jibonaronno/kicad_projects/README.md

# kicad_projects
1. Trailing Edge Dimmer ESP8266
