jibonaronno/kicad_projects/dimmer_trailing_edge/nodemcu01/README.md

# Trailing Edge Dimmer Description

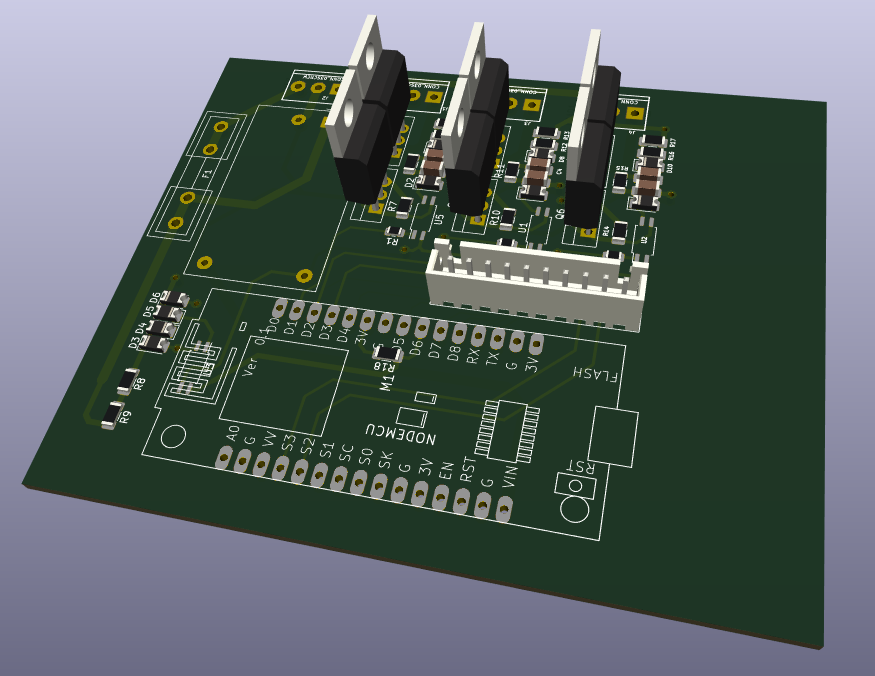
[picture p1: dimmer_trailing_edge/nodemcu01/image.png]


Practically there are 2 types of dimmer. 

1. Raising Edge
2. Trailing Edge

Based on the swithing time position after zero cross detection. 

Here is a simple concept of raising and trailing edge switching.

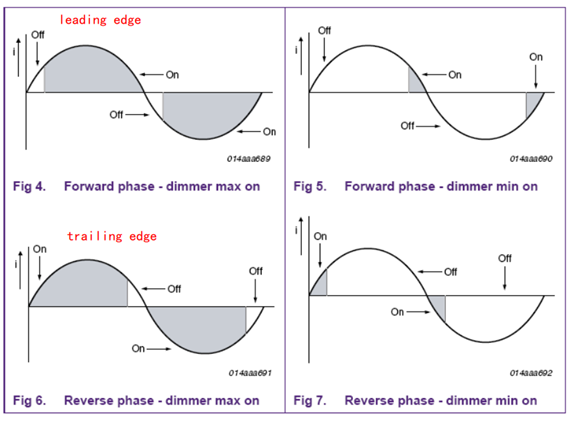
[picture p2: dimmer_trailing_edge/nodemcu01/image 1.png]


This project focused on trailing edge dimmer construction. 

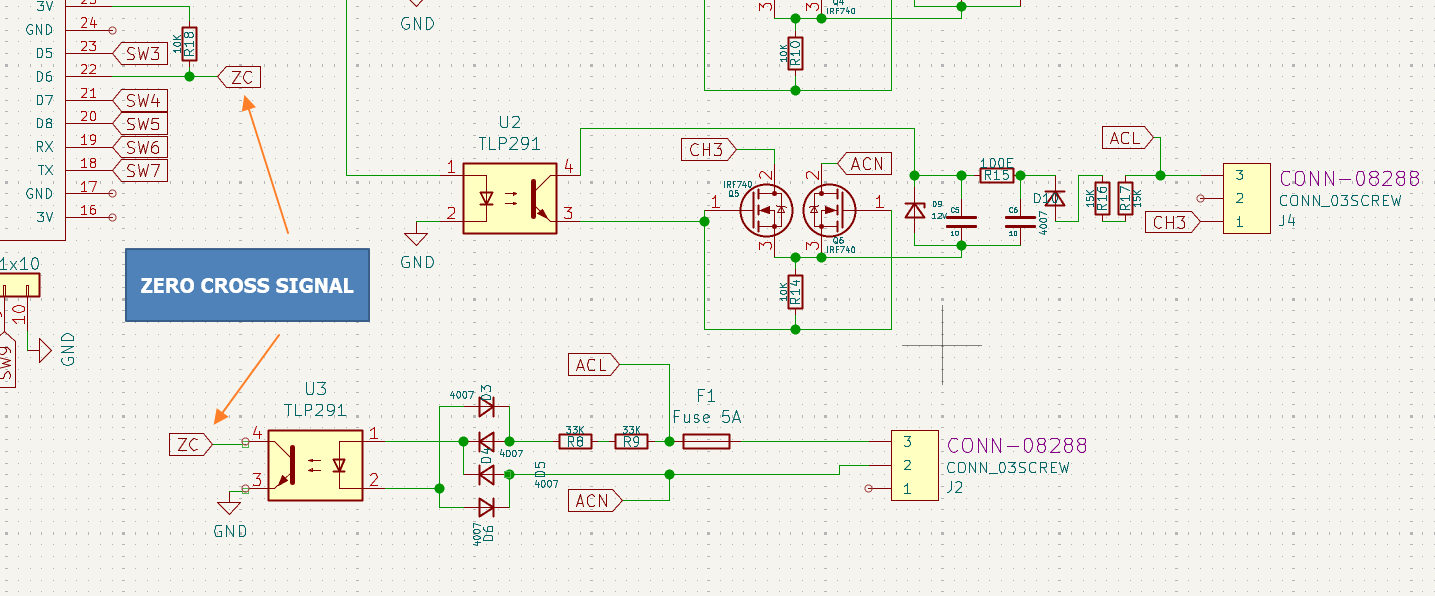
[picture p3: dimmer_trailing_edge/nodemcu01/image 2.png]


Here it stores energy in C5 and C6 from power line ACL and ACN. From the perspective it only uses positive cycle of the phase to store energy. Turning on the mosfet is occured by Opto U2, and turning off is happened by R14 (10k) . So this dimmer is not suitable for more than 200W. 

Found another solution as below:

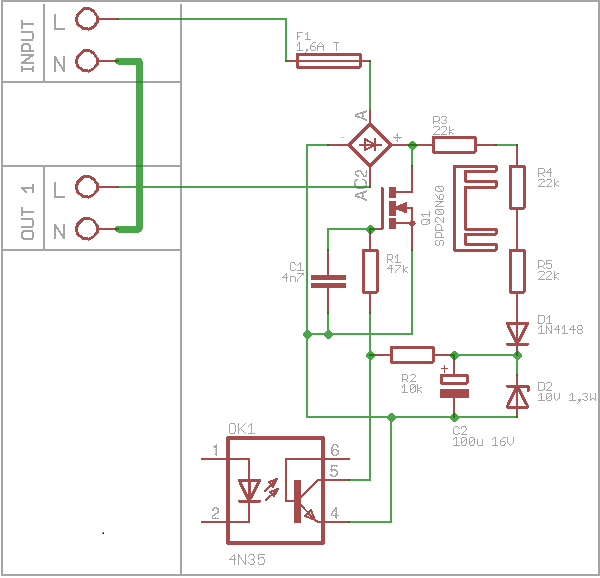
[picture p4: dimmer_trailing_edge/nodemcu01/image 3.png]


This 3 channel dimmer is build on ESP8266 NodeMCU . Complete Kicad Drawing is available in [https://github.com/jibonaronno/kicad_projects/tree/main/dimmer_trailing_edge/nodemcu01](https://github.com/jibonaronno/kicad_projects/tree/main/dimmer_trailing_edge/nodemcu01)

The Arduino code is available under qnod01 folder. It is required to provide correct Wifi credentials the the Arduino code and also need to find the IP address of NodeMCU. After successfull connection between Wifi and NodeMCU, user can browse to the NodeMCU IP Address from phone browser and control dimming.
