jibonaronno/kicad_projects/dimmer_trailing_edge/nodemcu01/nodemcu01.kicad_pcb

## KiCad design dimmer_trailing_edge/nodemcu01/nodemcu01.kicad_pcb (2025-05-19)

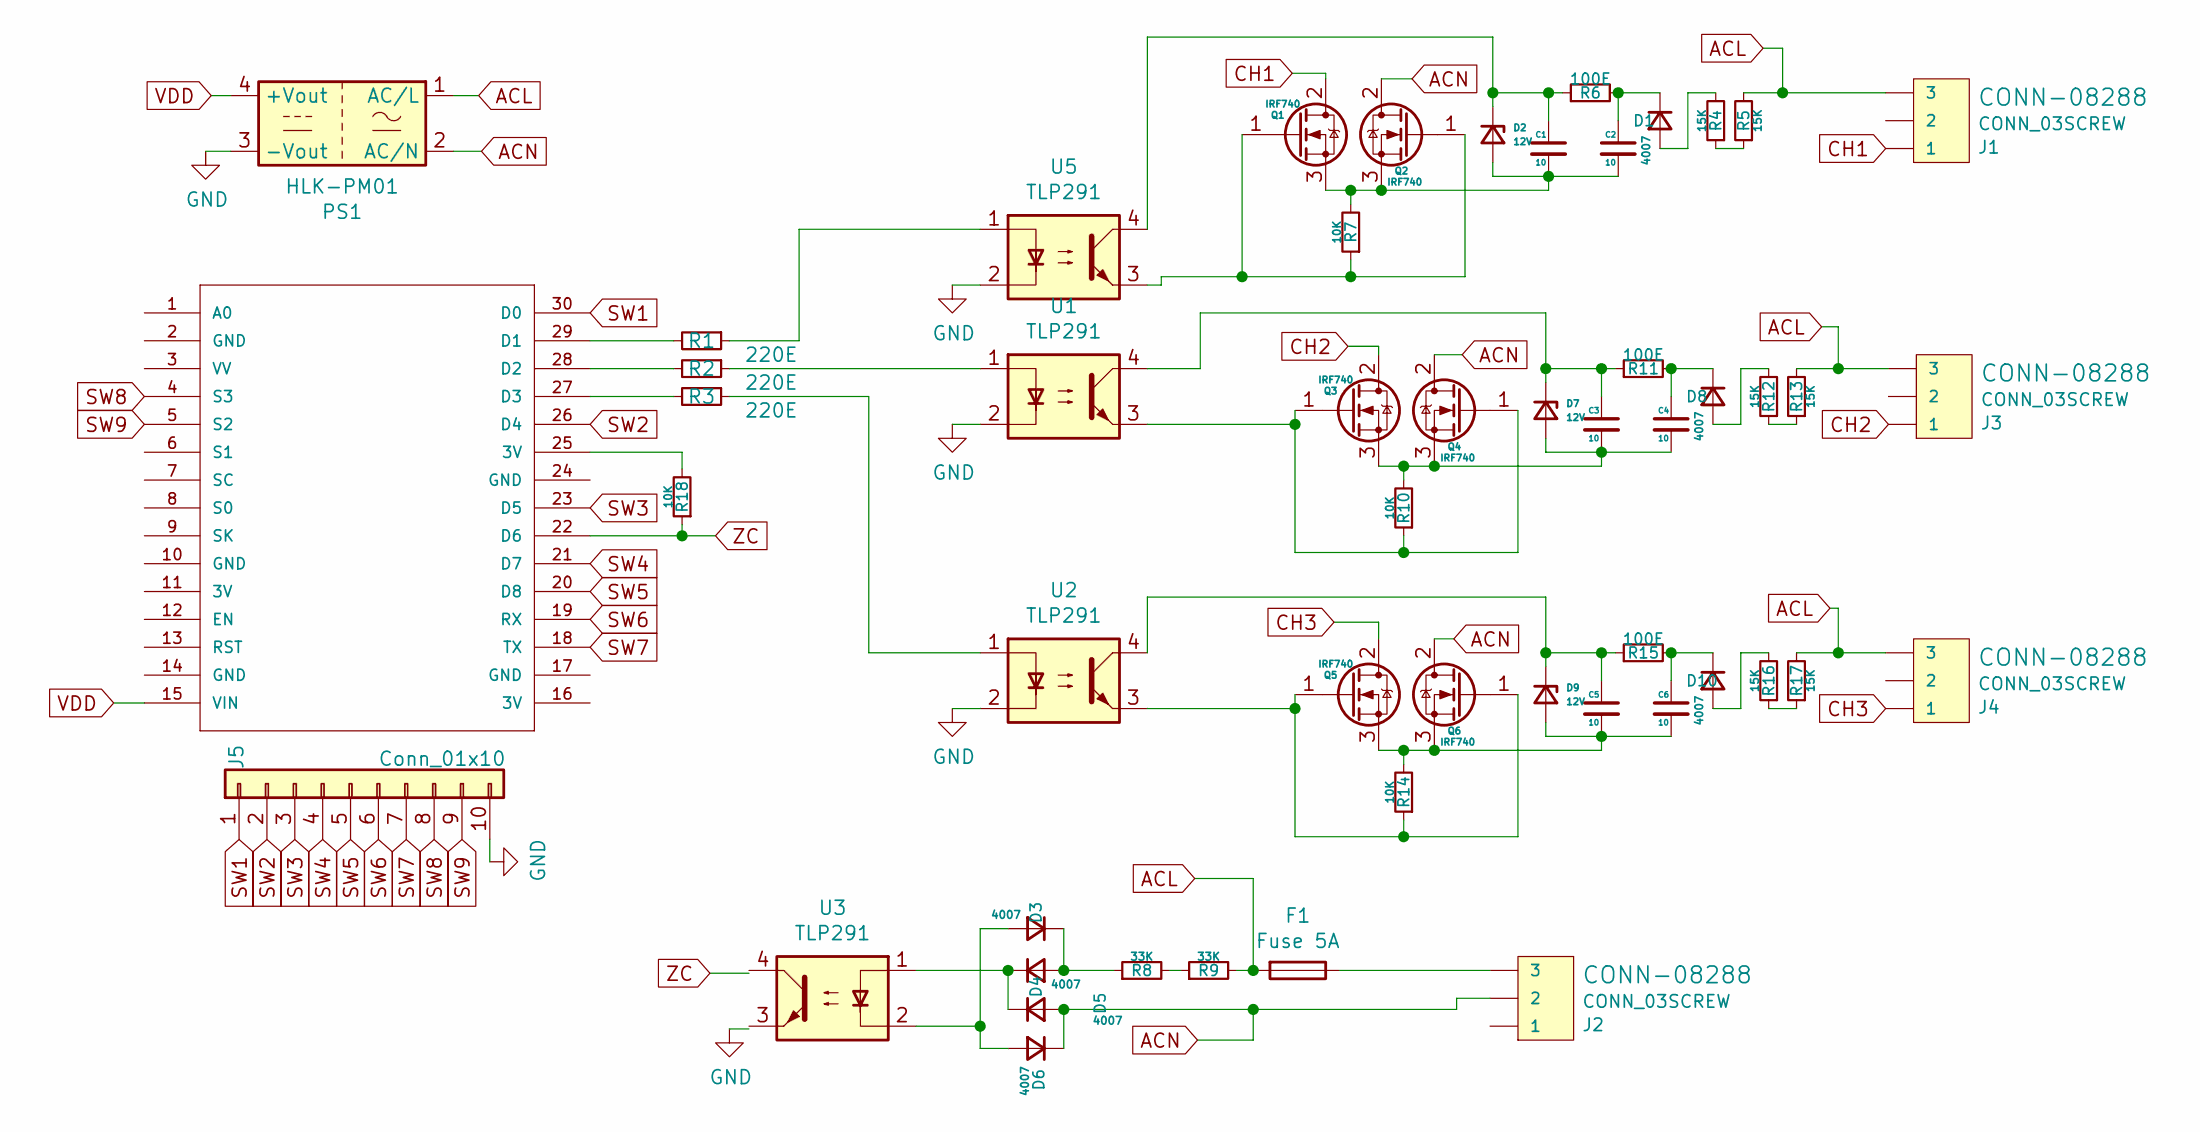
[picture p5: schematic nodemcu01.kicad_sch]

Parts:
C1, C2, C3, C4, C5, C6: 10; C_1206_3216Metric
D1, D3, D4, D5, D6, D8, D10: 4007; D_1206_3216Metric
D2, D7, D9: 12V; D_1206_3216Metric
F1: Fuse 5A; Fuseholder5x20_horiz_open_inline_Type-I
J1, J2, J3, J4: CONN_03SCREW; SCREWTERMINAL-3.5MM-3
J5: Conn_01x10; JST_XH_B10B-XH-A_1x10_P2.50mm_Vertical
M1: NODEMCU; nodemcu2-NODEMCU
PS1: HLK-PM01; Converter_ACDC_HiLink_HLK-PMxx
Q1, Q2, Q3, Q4, Q5, Q6: IRF740; TO-220-3_Vertical
R1, R2, R3: 220E; R_0805_2012Metric
R4, R5, R12, R13, R16, R17: 15K; R_1206_3216Metric
R6, R11, R15: 100E; R_1206_3216Metric
R7, R10, R14, R18: 10K; R_1206_3216Metric
R8, R9: 33K; R_1206_3216Metric
U1, U2, U3, U5: TLP291; SOIC-4_4.55x2.6mm_P1.27mm

Connections:
ACL: F1.2, J1.3, J3.3, J4.3, PS1.1 (AC/L), R5.2, R9.2, R13.2, R17.2
ACN: D5.2 (A), D6.1 (K), J2.2, PS1.2 (AC/N), Q2.2 (D), Q4.2 (D), Q6.2 (D)
CH1: J1.1, Q1.2 (D)
CH2: J3.1, Q3.2 (D)
CH3: J4.1, Q5.2 (D)
GND: J5.10, PS1.3 (-Vout), U1.2, U2.2, U3.3, U5.2
unnamed: C1.1, D2.1 (K), R6.1, U5.4
unnamed: C1.2, C2.2, D2.2 (A), Q1.3 (S), Q2.3 (S), R7.2
unnamed: C2.1, D1.1 (K), R6.2
unnamed: C3.1, D7.1 (K), R11.1, U1.4
unnamed: C3.2, C4.2, D7.2 (A), Q3.3 (S), Q4.3 (S), R10.2
unnamed: C4.1, D8.1 (K), R11.2
unnamed: C5.1, D9.1 (K), R15.1, U2.4
unnamed: C5.2, C6.2, D9.2 (A), Q5.3 (S), Q6.3 (S), R14.2
unnamed: C6.1, D10.1 (K), R15.2
unnamed: D1.2 (A), R4.2
unnamed: D3.1 (K), D4.2 (A), R8.1
unnamed: D3.2 (A), D6.2 (A), U3.2
unnamed: D4.1 (K), D5.1 (K), U3.1
unnamed: D8.2 (A), R12.2
unnamed: D10.2 (A), R16.2
unnamed: F1.1, J2.3
unnamed: M1.25 (3V), R18.2
unnamed: M1.27 (D3), R3.2
unnamed: M1.28 (D2), R2.2
unnamed: M1.29 (D1), R1.2
unnamed: Q1.1 (G), Q2.1 (G), R7.1, U5.3
unnamed: Q3.1 (G), Q4.1 (G), R10.1, U1.3
unnamed: Q5.1 (G), Q6.1 (G), R14.1, U2.3
unnamed: R1.1, U5.1
unnamed: R2.1, U1.1
unnamed: R3.1, U2.1
unnamed: R4.1, R5.1
unnamed: R8.2, R9.1
unnamed: R12.1, R13.1
unnamed: R16.1, R17.1
SW1: J5.1, M1.30 (D0)
SW2: J5.2, M1.26 (D4)
SW3: J5.3, M1.23 (D5)
SW4: J5.4, M1.21 (D7)
SW5: J5.5, M1.20 (D8)
SW6: J5.6, M1.19 (RX)
SW7: J5.7, M1.18 (TX)
SW8: J5.8, M1.4 (S3)
SW9: J5.9, M1.5 (S2)
VDD: M1.15 (VIN), PS1.4 (+Vout)
ZC: M1.22 (D6), R18.1, U3.4

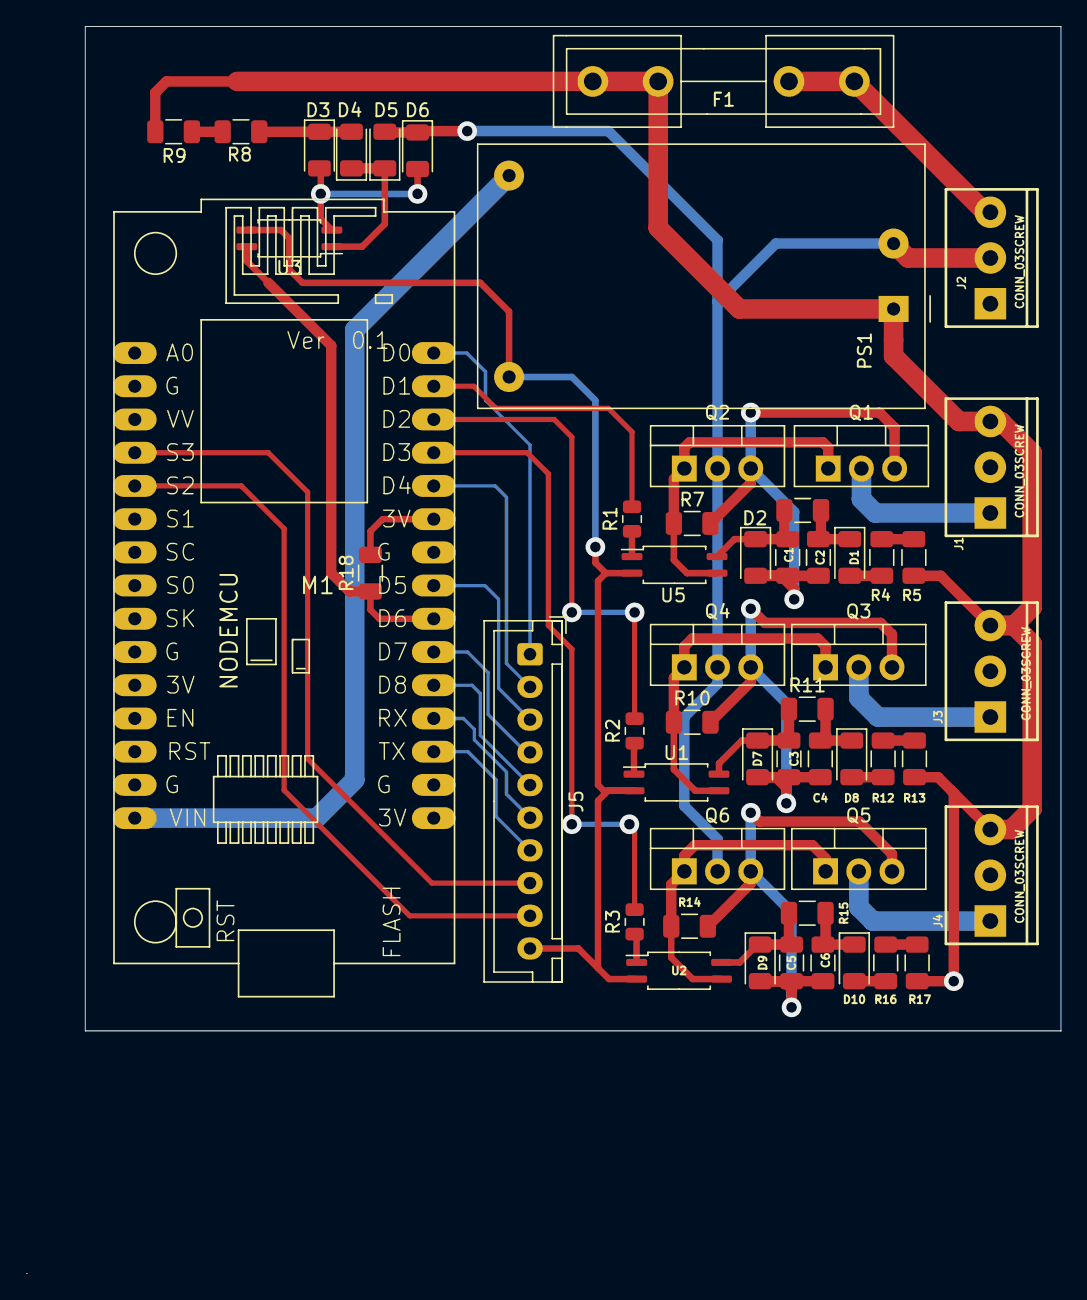
[picture p6: board nodemcu01.kicad_pcb from above]

Board: 2 copper layers, 74.6 x 76.8 mm, 52 parts (0 on the bottom side), 47 nets.
